Hummelkoenig/Robotarm_Driver/Driver/plan.png

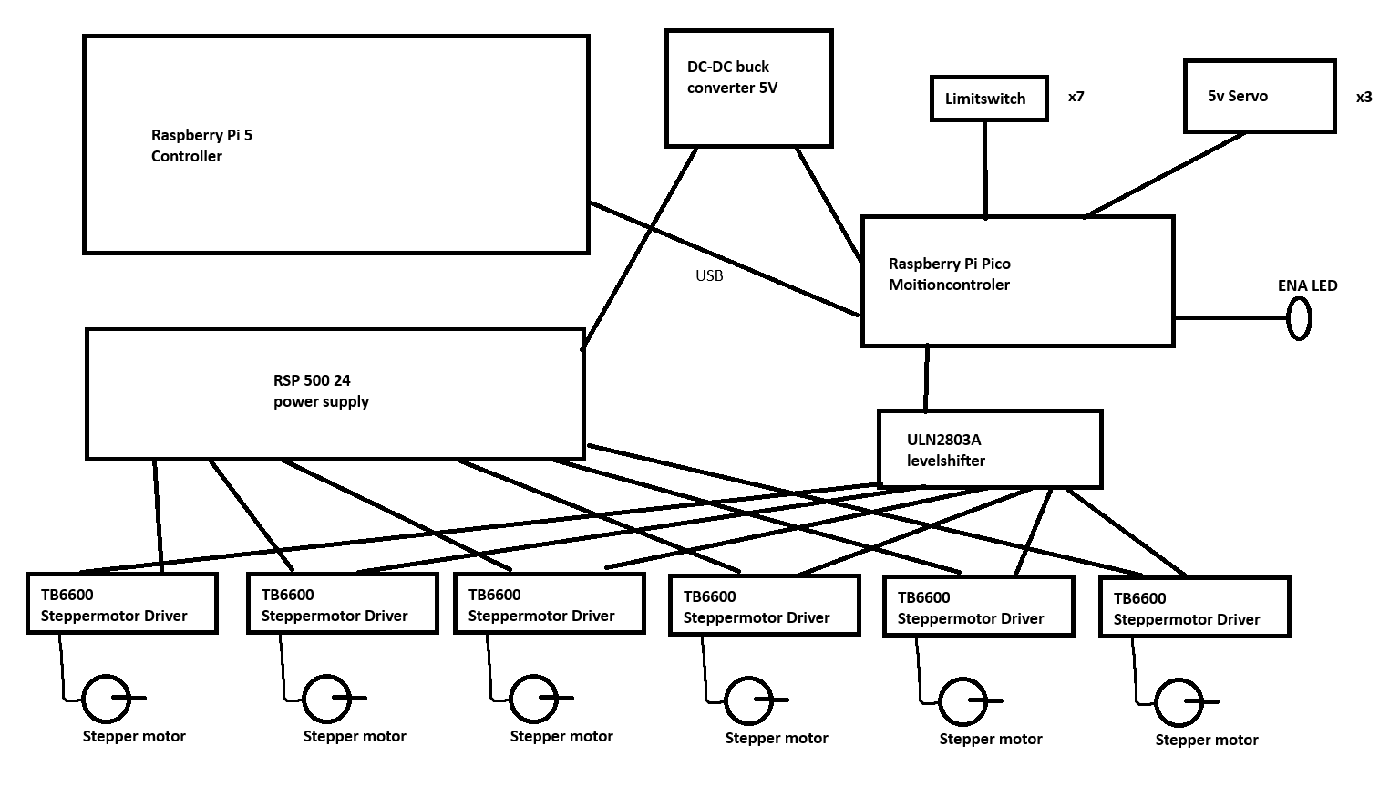
Driver/plan.png
