Hummelkoenig/Robotarm_Driver/Driver/Box/Bottom.dxf

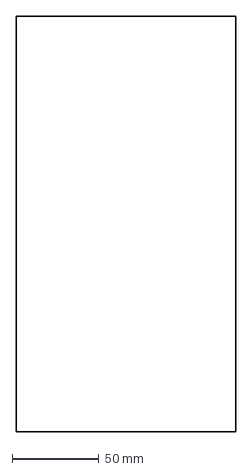
[picture p2: CAD file, 2026-08-25]
Driver/Box/Bottom.dxf
127.0 x 240.0 mm
