Hummelkoenig/Robotarm_Driver/Driver/Box/rightside.dxf

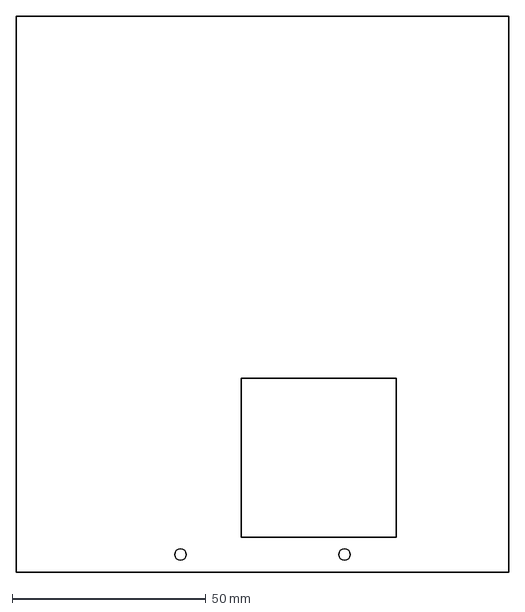
[picture p3: CAD file, 2026-08-25]
Driver/Box/rightside.dxf
127.0 x 143.5 mm
