Hummelkoenig/Robotarm_Driver/Driver/Box/back.dxf

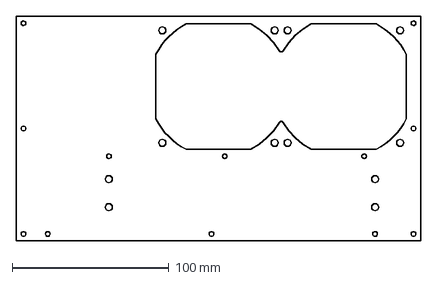
[picture p4: CAD file, 2026-08-25]
Driver/Box/back.dxf
258.0 x 143.5 mm
