Hummelkoenig/Robotarm_Driver/Driver/Box/front.dxf

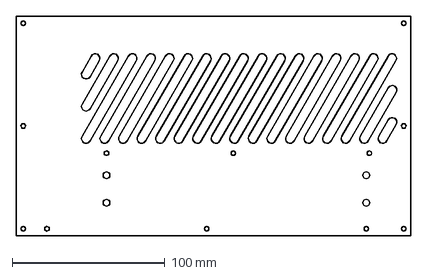
[picture p5: CAD file, 2026-08-25]
Driver/Box/front.dxf
258.0 x 143.5 mm
