Hummelkoenig/Robotarm_Driver/Driver/Box/leftside.dxf

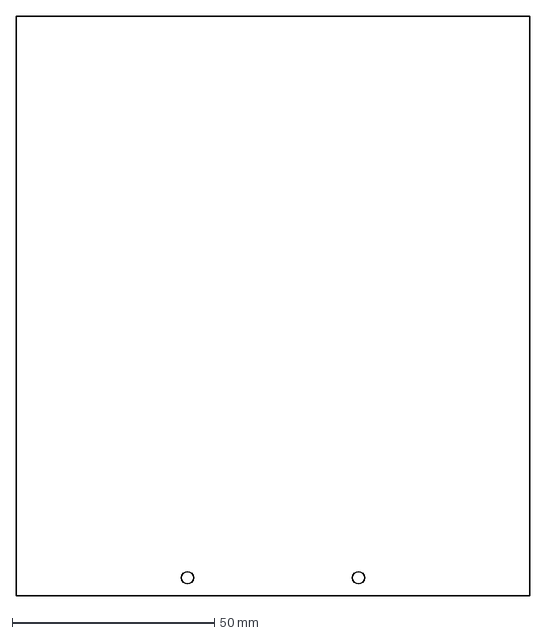
[picture p6: CAD file, 2026-08-25]
Driver/Box/leftside.dxf
127.0 x 143.5 mm
