Hummelkoenig/Robotarm_Driver/Driver/Box/screw on plate.dxf

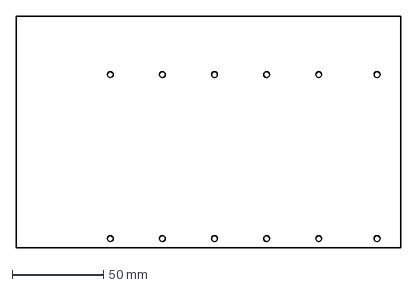
[picture p7: CAD file, 2026-08-25]
Driver/Box/screw on plate.dxf
211.0 x 127.0 mm
