Hummelkoenig/Robotarm_Driver/(list of files, cad)

Other CAD files:
Driver/Box/Bottom.f3d
Driver/Box/Full.f3z
Driver/Box/back.f3d
Driver/Box/front.f3d
Driver/Box/leftside.f3d
Driver/Box/rightside.f3d
Driver/Box/screw on plate.f3d
