Hummelkoenig/Robotarm_Driver/Driver/RSP-500-DB.pdf

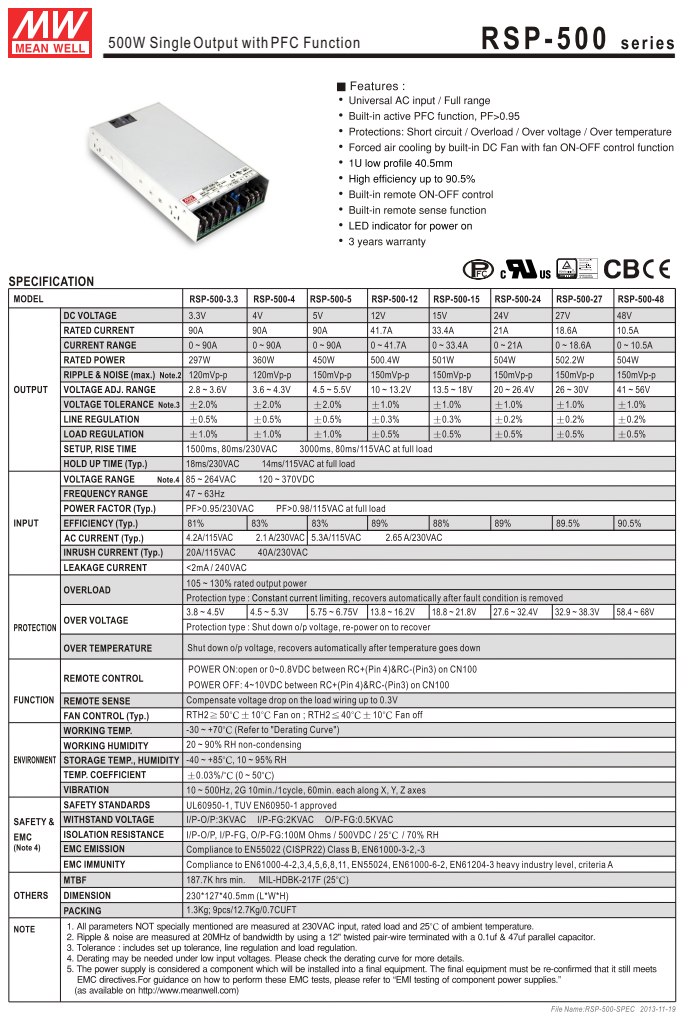
[picture p8: page 1]

500W Single Output with PFC Function

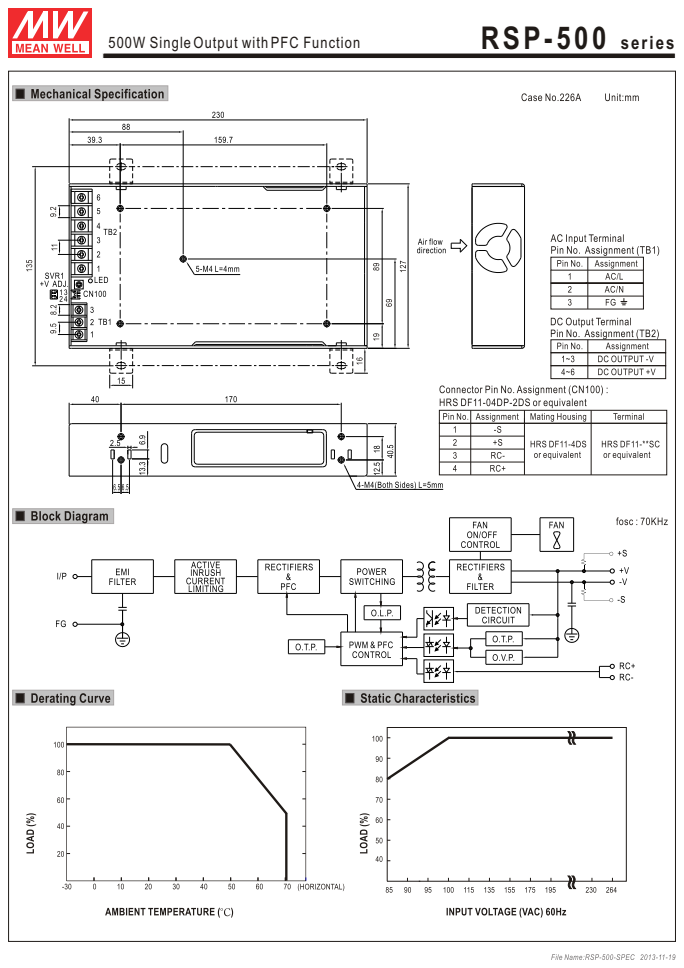
[picture p9: page 2]
USP-22530 series 500W Single Output with PFC Function; RSP-500 series

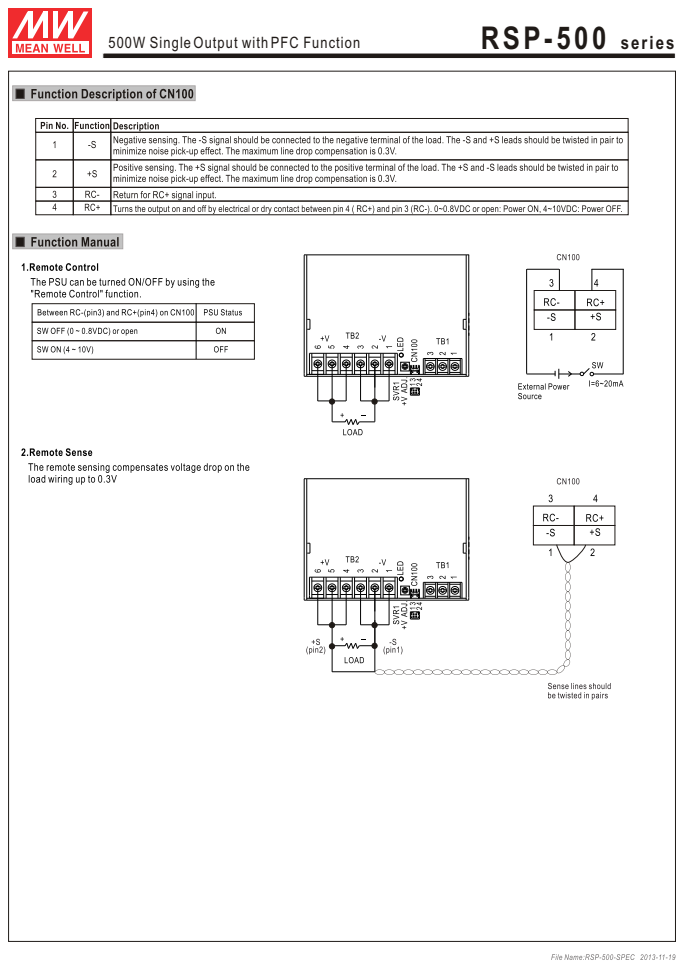
[picture p10: page 3]
USP-22530 series 500W Single Output with PFC Function; RSP-500 series
