Hummelkoenig/Robotarm_Driver/Driver/motion_controller_board/Robotdriver.kicad_pcb

## KiCad design Driver/motion_controller_board/Robotdriver.kicad_pcb (2026-08-25)

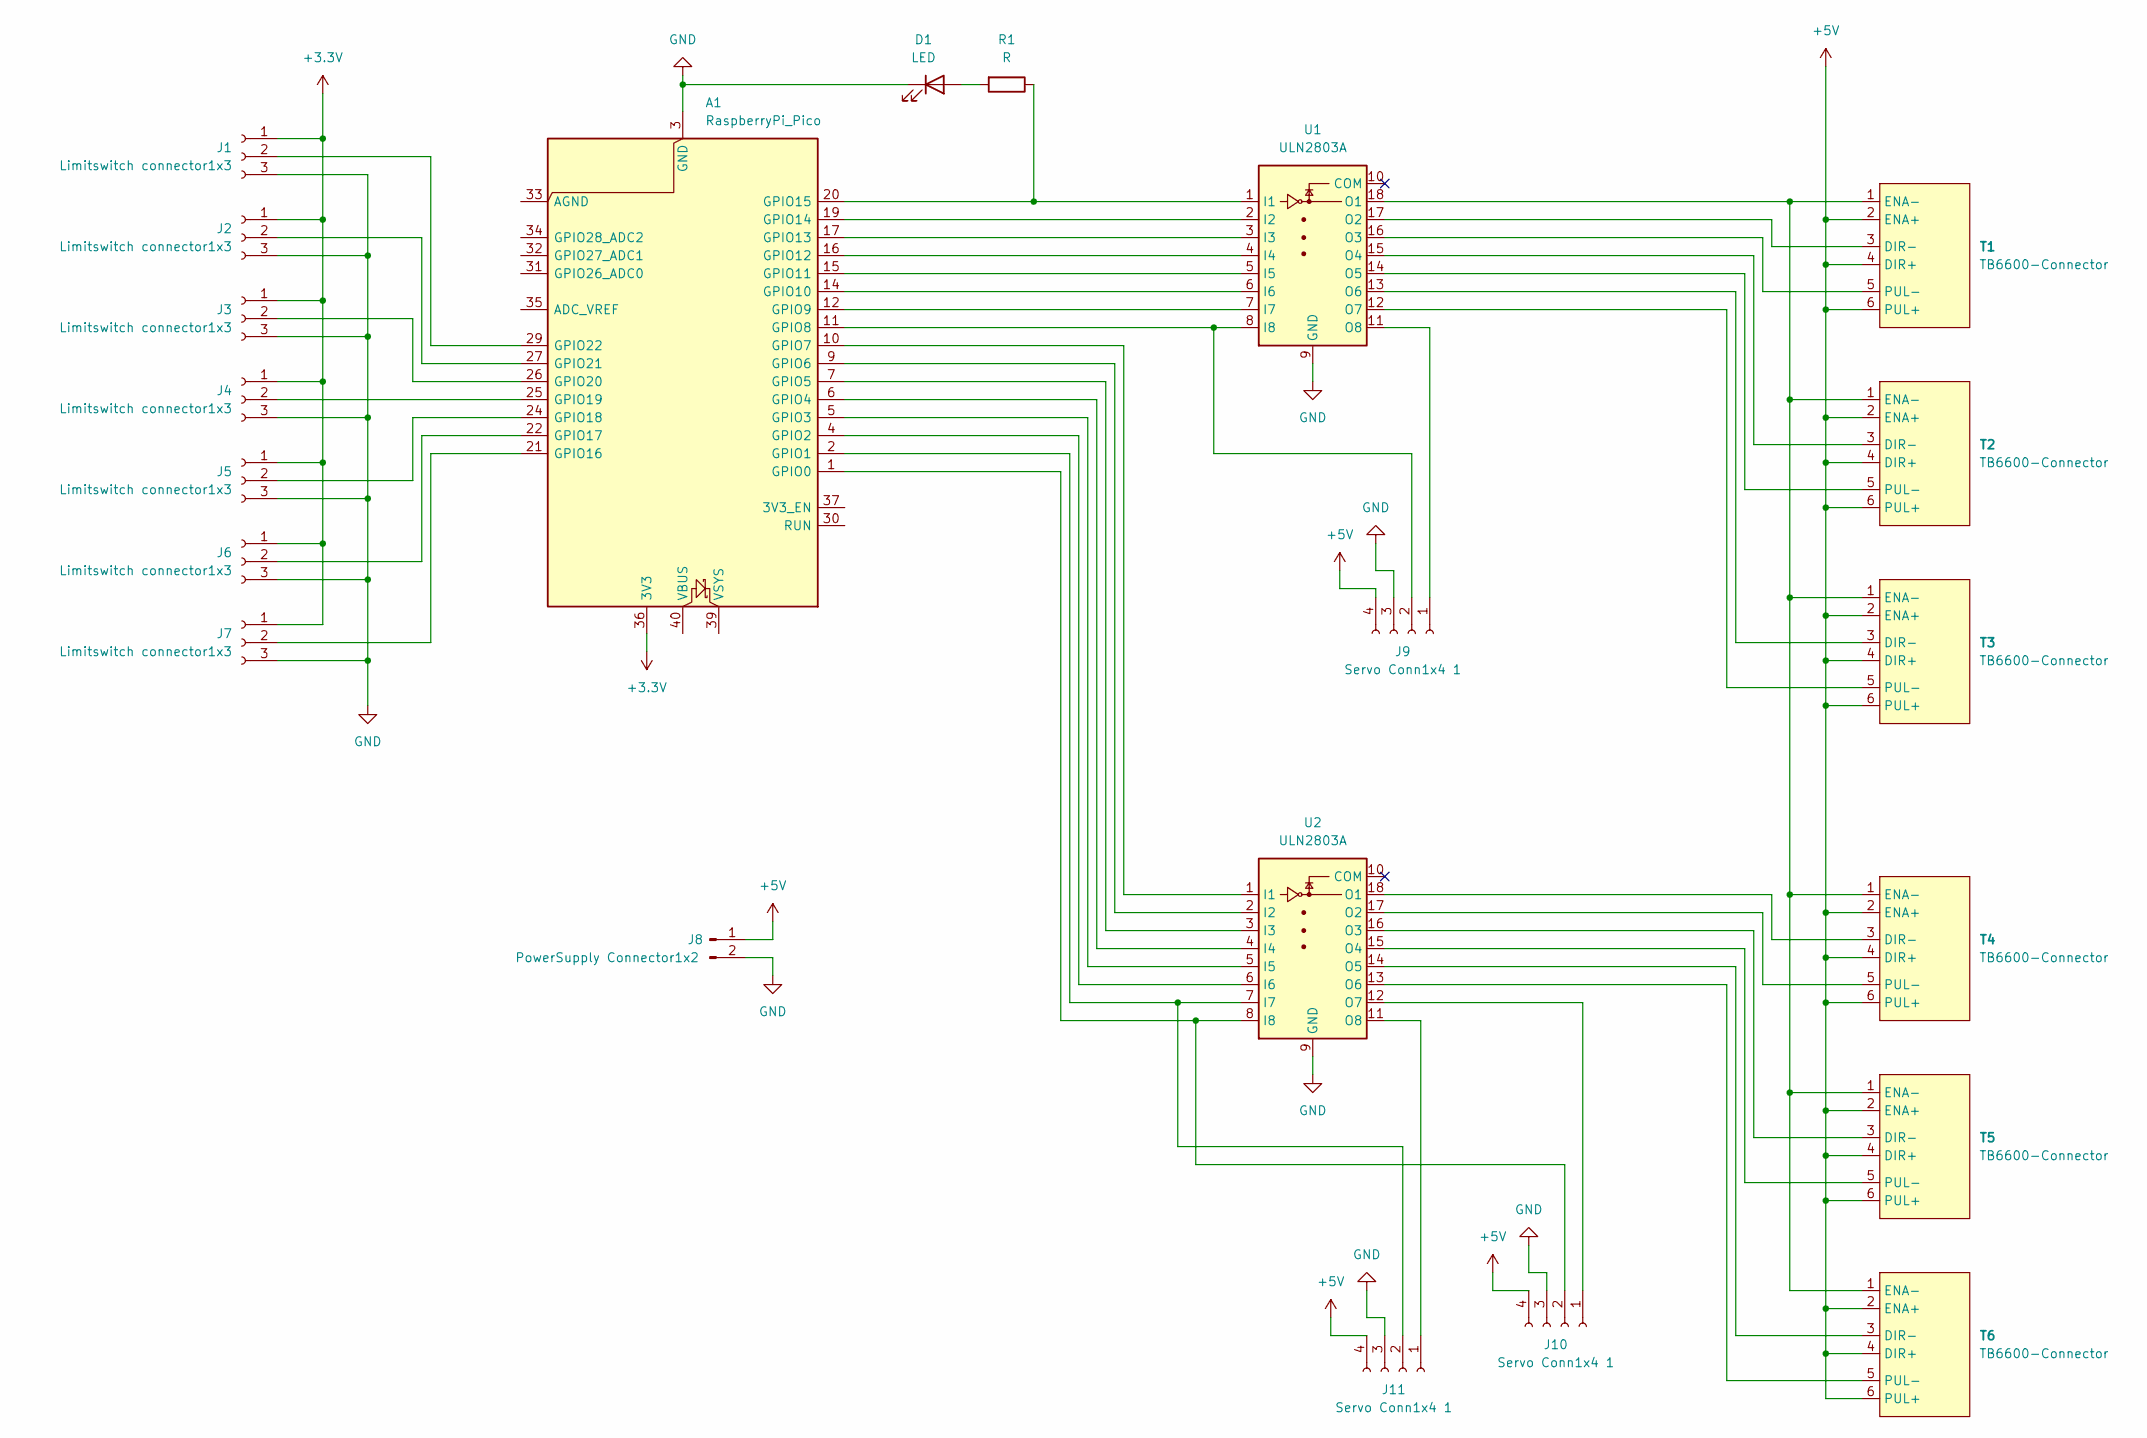
[picture p11: schematic Robotdriver.kicad_sch]

Parts:
A1: RaspberryPi_Pico; RaspberryPi_Pico_Common_Unspecified
D1: LED; LED_D5.0mm
J1, J2, J3, J4, J5, J6, J7: Limitswitch connector1x3; JST_EH_B3B-EH-A_1x03_P2.50mm_Vertical
J8: PowerSupply Connector1x2; JST_EH_B2B-EH-A_1x02_P2.50mm_Vertical
J9, J10, J11: Servo Conn1x4 1; JST_EH_B4B-EH-A_1x04_P2.50mm_Vertical
R1: R; R_Axial_DIN0516_L15.5mm_D5.0mm_P20.32mm_Horizontal
T1, T2, T3, T4, T5, T6: TB6600-Connector; JST_EH_B6B-EH-A_1x06_P2.50mm_Vertical
U1, U2: ULN2803A; CERDIP-18_W7.62mm_SideBrazed

Connections:
+3.3V: A1.36 (3V3), J1.1, J2.1, J3.1, J4.1, J5.1, J6.1, J7.1
+5V: J8.1, J9.4, J10.4, J11.4, T1.2 (ENA+), T1.4 (DIR+), T1.6 (PUL+), T2.2 (ENA+), T2.4 (DIR+), T2.6 (PUL+), T3.2 (ENA+), T3.4 (DIR+), T3.6 (PUL+), T4.2 (ENA+), T4.4 (DIR+), T4.6 (PUL+), T5.2 (ENA+), T5.4 (DIR+), T5.6 (PUL+), T6.2 (ENA+), T6.4 (DIR+), T6.6 (PUL+)
GND: A1.3 (GND), A1.8 (GND), A1.13 (GND), A1.18 (GND), A1.23 (GND), A1.28 (GND), A1.38 (GND), D1.1 (K), J1.3, J2.3, J3.3, J4.3, J5.3, J6.3, J7.3, J8.2, J9.3, J10.3, J11.3, U1.9 (GND), U2.9 (GND)
unnamed: A1.1 (GPIO0), J10.2, U2.8 (I8)
unnamed: A1.2 (GPIO1), J11.2, U2.7 (I7)
unnamed: A1.4 (GPIO2), U2.6 (I6)
unnamed: A1.5 (GPIO3), U2.5 (I5)
unnamed: A1.6 (GPIO4), U2.4 (I4)
unnamed: A1.7 (GPIO5), U2.3 (I3)
unnamed: A1.9 (GPIO6), U2.2 (I2)
unnamed: A1.10 (GPIO7), U2.1 (I1)
unnamed: A1.11 (GPIO8), J9.2, U1.8 (I8)
unnamed: A1.12 (GPIO9), U1.7 (I7)
unnamed: A1.14 (GPIO10), U1.6 (I6)
unnamed: A1.15 (GPIO11), U1.5 (I5)
unnamed: A1.16 (GPIO12), U1.4 (I4)
unnamed: A1.17 (GPIO13), U1.3 (I3)
unnamed: A1.19 (GPIO14), U1.2 (I2)
unnamed: A1.20 (GPIO15), R1.1, U1.1 (I1)
unnamed: A1.21 (GPIO16), J7.2
unnamed: A1.22 (GPIO17), J6.2
unnamed: A1.24 (GPIO18), J5.2
unnamed: A1.25 (GPIO19), J4.2
unnamed: A1.26 (GPIO20), J3.2
unnamed: A1.27 (GPIO21), J2.2
unnamed: A1.29 (GPIO22), J1.2
unnamed: D1.2 (A), R1.2
unnamed: J9.1, U1.11 (O8)
unnamed: J10.1, U2.12 (O7)
unnamed: J11.1, U2.11 (O8)
unnamed: T1.3 (DIR-), U1.17 (O2)
unnamed: T1.1 (ENA-), T2.1 (ENA-), T3.1 (ENA-), T4.1 (ENA-), T5.1 (ENA-), T6.1 (ENA-), U1.18 (O1)
unnamed: T1.5 (PUL-), U1.16 (O3)
unnamed: T2.3 (DIR-), U1.15 (O4)
unnamed: T2.5 (PUL-), U1.14 (O5)
unnamed: T3.3 (DIR-), U1.13 (O6)
unnamed: T3.5 (PUL-), U1.12 (O7)
unnamed: T4.3 (DIR-), U2.18 (O1)
unnamed: T4.5 (PUL-), U2.17 (O2)
unnamed: T5.3 (DIR-), U2.16 (O3)
unnamed: T5.5 (PUL-), U2.15 (O4)
unnamed: T6.3 (DIR-), U2.14 (O5)
unnamed: T6.5 (PUL-), U2.13 (O6)

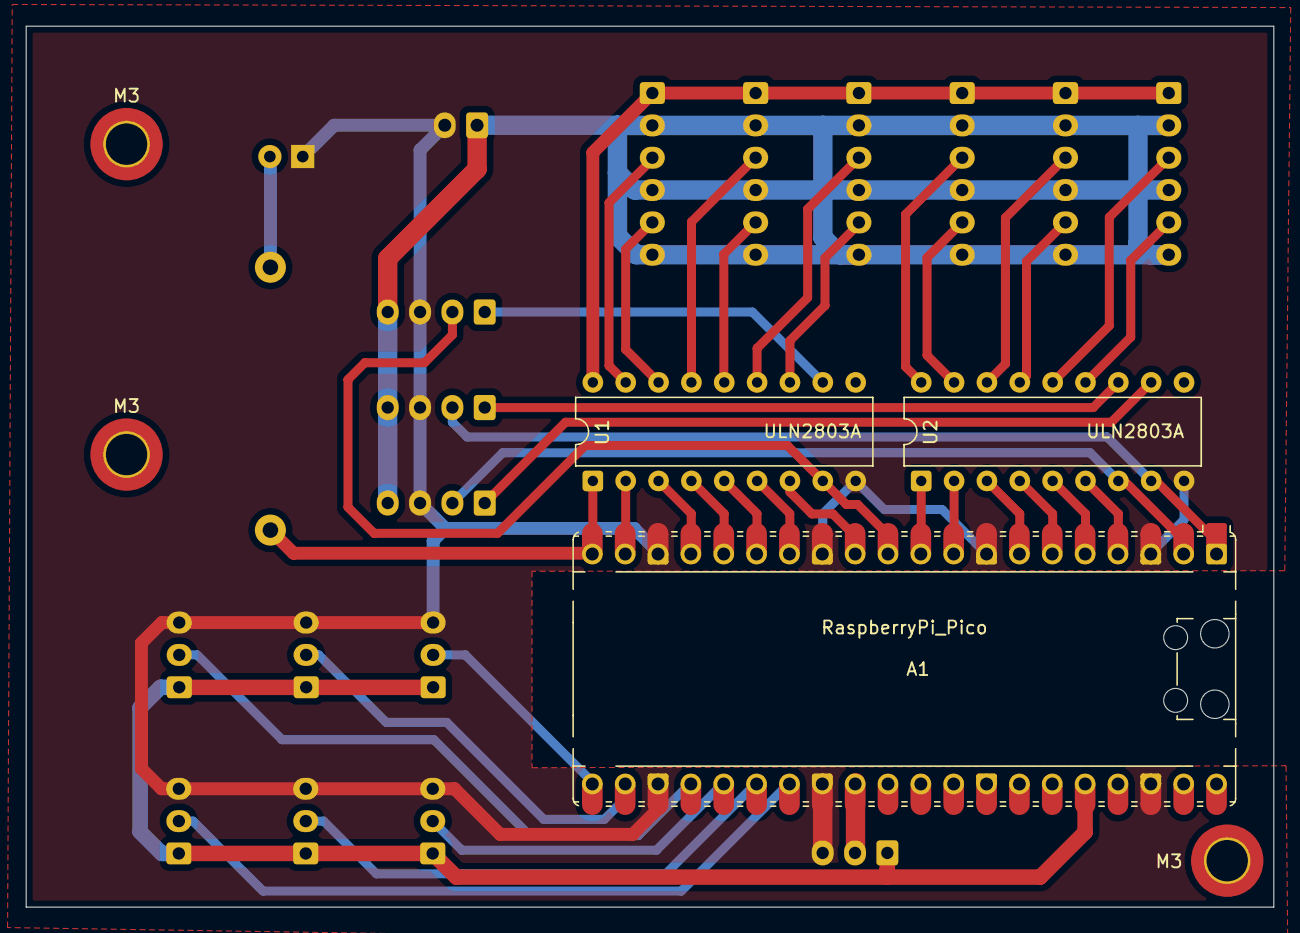
[picture p12: board Robotdriver.kicad_pcb from above]

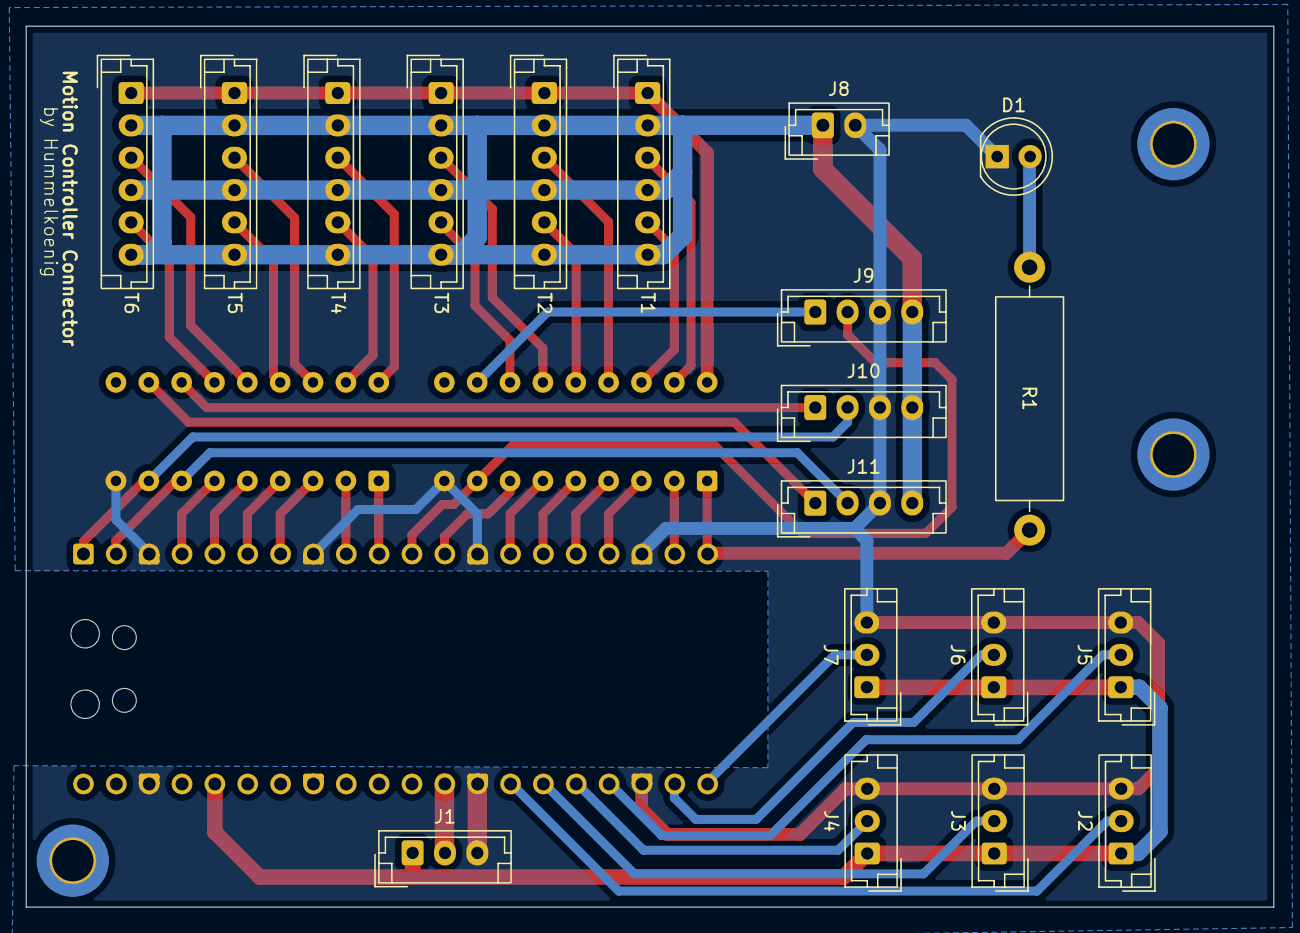
[picture p13: board Robotdriver.kicad_pcb from below]

Board: 2 copper layers, 96.5 x 68.1 mm, 25 parts (19 on the bottom side), 43 nets.

Other parts of the board:
M3, M3#2, M3#3: MountingHole_3.2mm_M3_DIN965_Pad_TopBottom
