Hummelkoenig/Robotarm_Driver/(commit log)

2026-08-25 dxf files
    [Bottom.dxf, back.dxf, front.dxf, leftside.dxf, rightside.dxf, screw on plate.dxf]
2026-09-09 Add MicroPython version of Pico controller
2026-09-11 Make Pico motor control non-blocking
2026-09-16 finished, no homing
